dwan6767/UNIOPME/README.md

# Power Meter V.0






An AC power meter project that measures RMS current, frequency, and THD using MicroPython on a Raspberry Pi Pico.

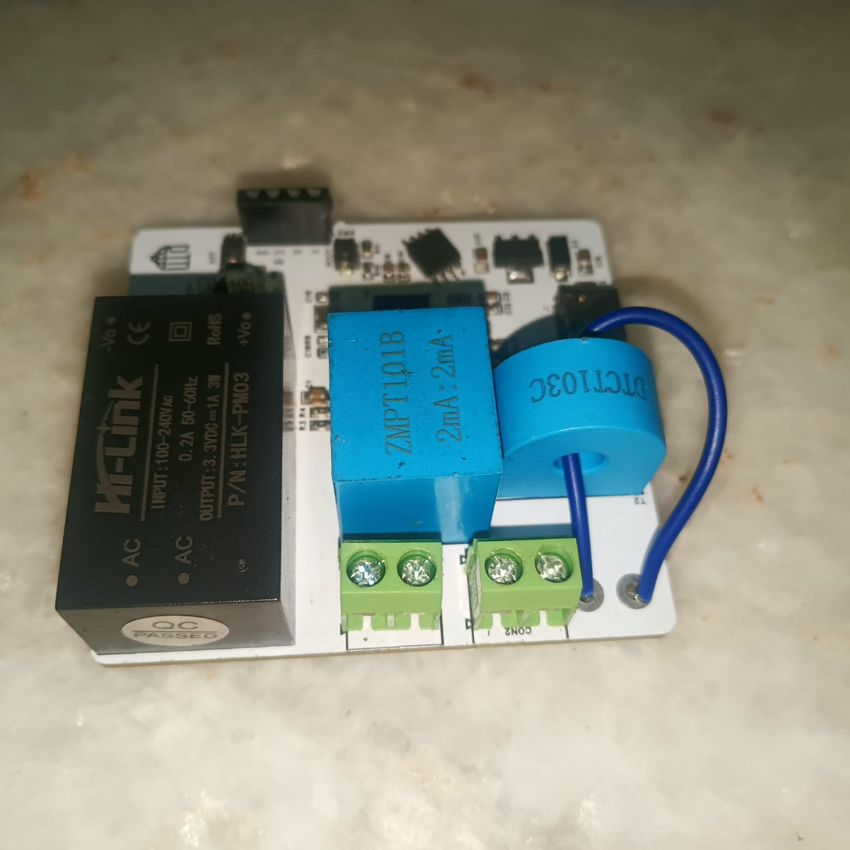
[picture p1: Models/0.png]
Power Meter


## Hardware

| Component | Description |
|---|---|
| Raspberry Pi Pico | Microcontroller |
| ZMPT101B | AC Voltage Sensor (GPIO 26) |
| ZMCT103C | AC Current Sensor (GPIO 27) |

**Schematic:** [View PDF](Designs/schematic.pdf)

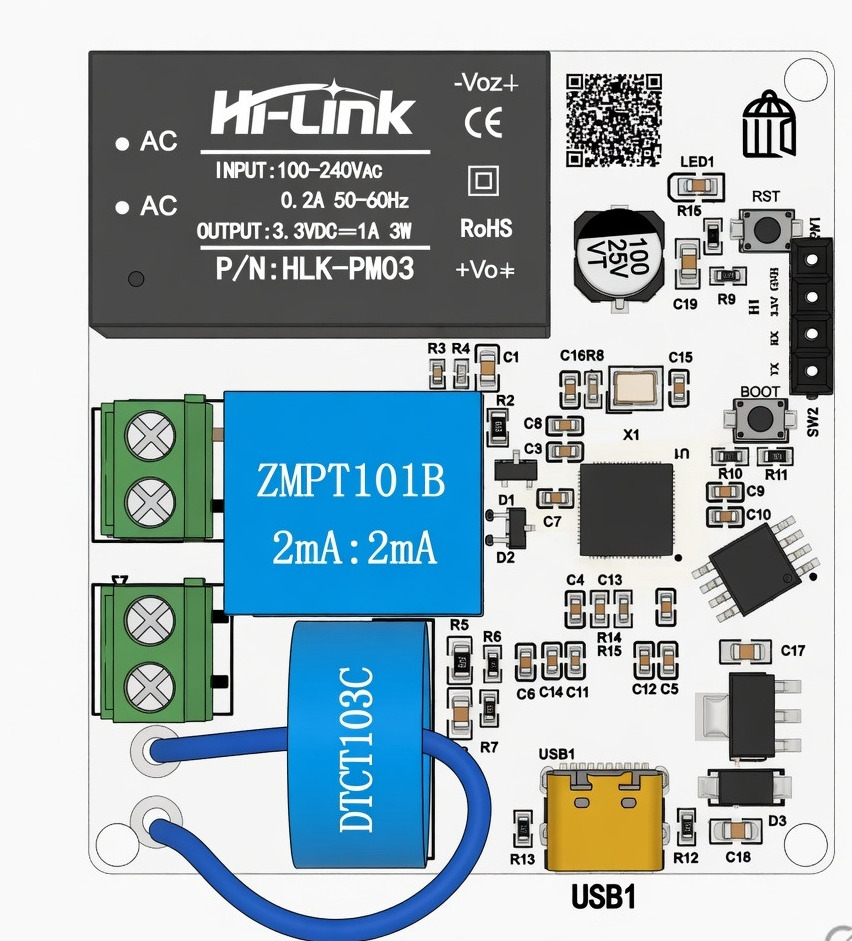
[picture p2: Models/2d_model.jpeg]
2D Model


## Firmware

Written in MicroPython. Samples at 5 kHz (500 samples per reading) and computes RMS values after DC offset removal.

### Features

- **RMS Current** measurement
- **Frequency** detection via zero-crossing
- **THD** (Total Harmonic Distortion) via FFT analysis
- Real-time serial output

### Calibration Factors

- `ICAL = 16.667 / 3` — Current calibration

### Usage

Flash `Firmware/main.py` to the Pico and monitor via serial REPL.

## Project Structure

```
Hardware/
├── Designs/        # Schematic (schematic.pdf), EasyEDA project (rp.eprj), Gerber files (power.zip)
├── Docs/           # Project report and documentation
├── Firmware/       # MicroPython source (main.py)
├── Models/         # 3D renders, photos, and enclosure PDFs
└── README.md       # This file
```

## Gallery

| 3D Renders | Test Setup |
|---|---|
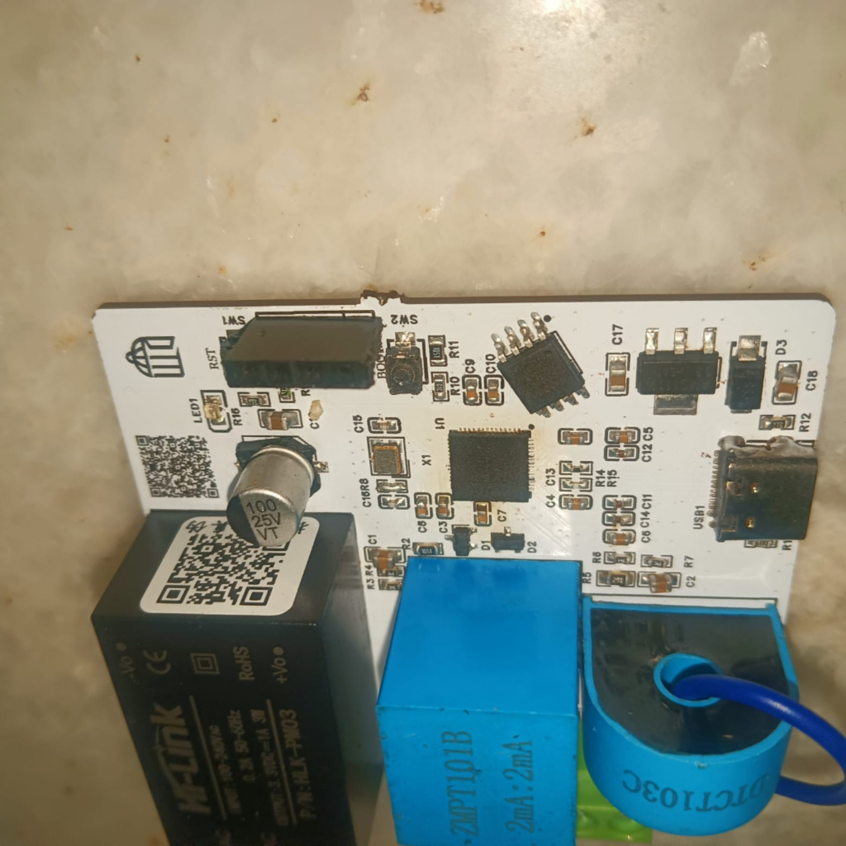
[picture p3: Models/1.png]
Model 1
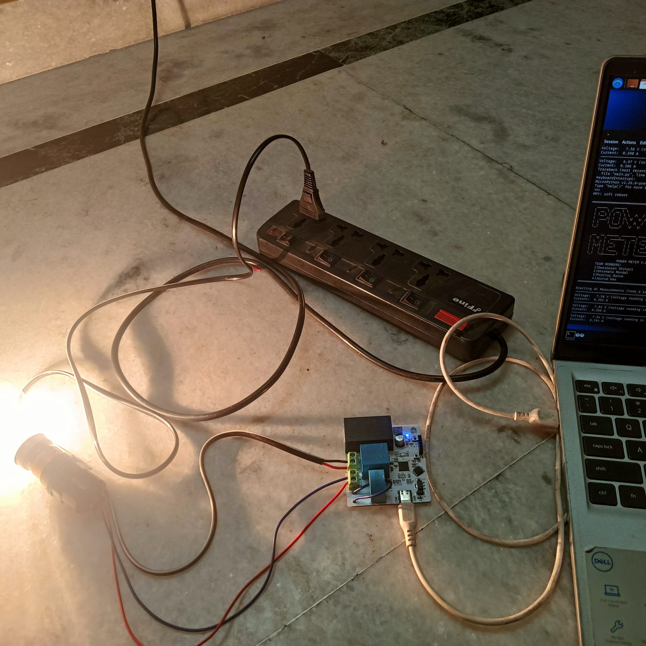
[picture p4: Models/test_setup.jpeg]
Test Setup
|  |  |
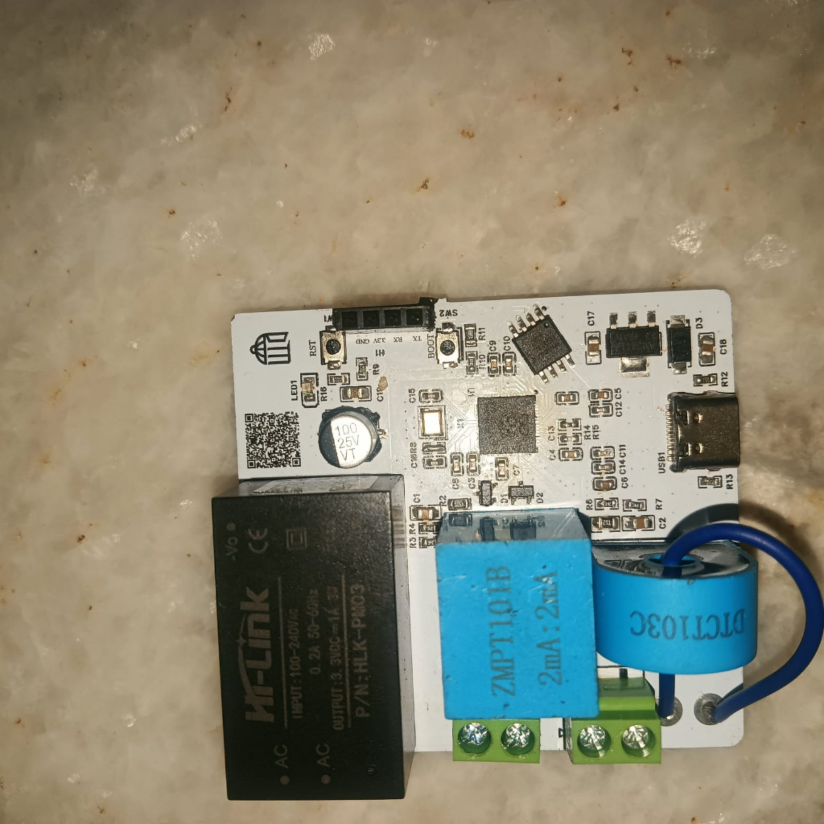
[picture p5: Models/2.png]
Model 2
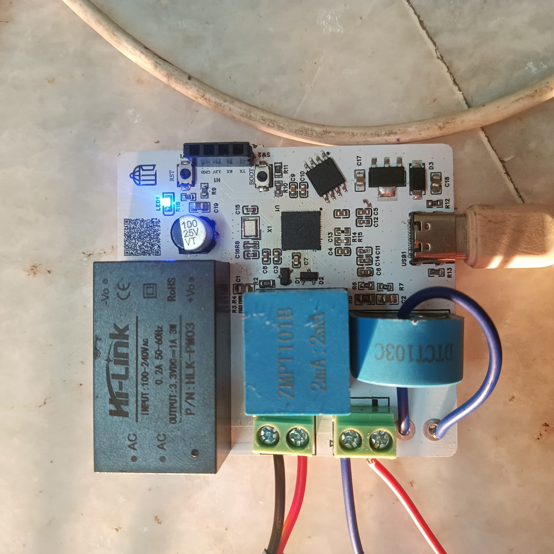
[picture p6: Models/test.jpeg]
Test
|  |  |
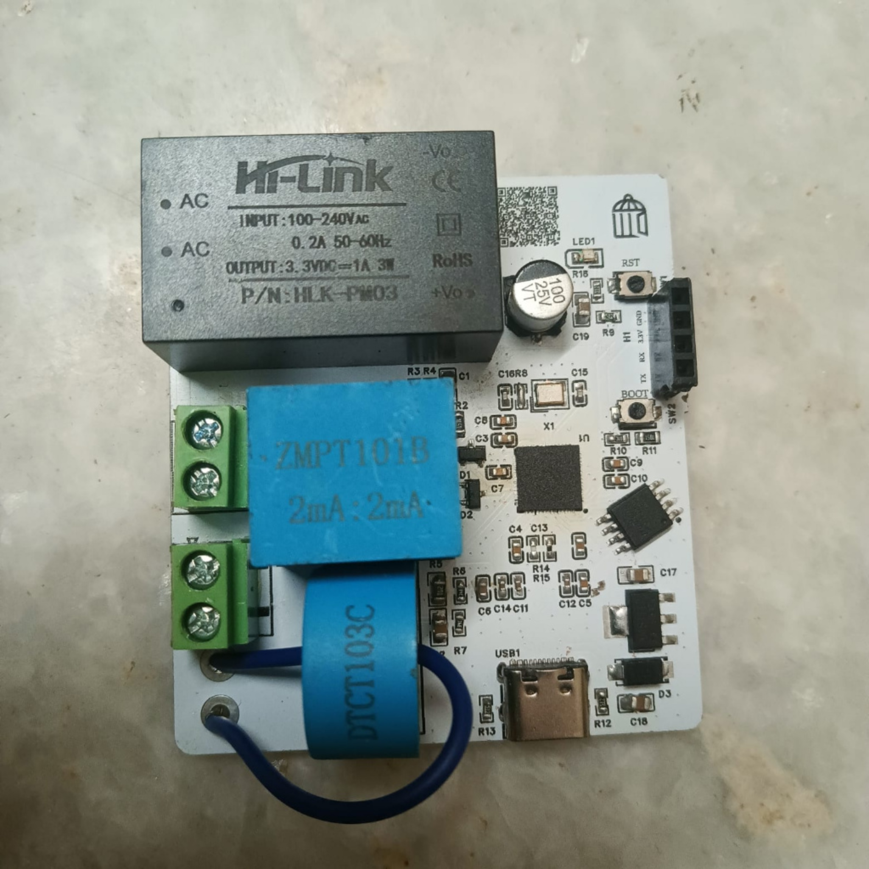
[picture p7: Models/3.png]
Model 3
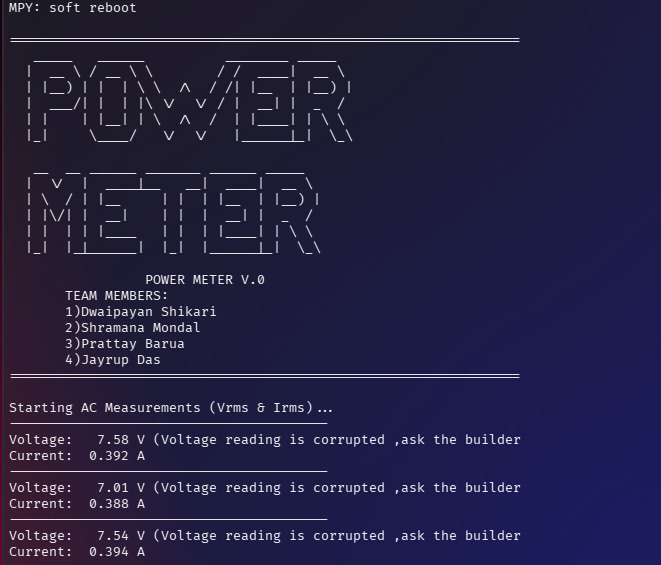
[picture p8: Models/test_soft.jpeg]
Test Software
|  |  |

## License

This project is certified [Open Source Hardware](https://oshwa.org/definition/) under the [CERN Open Hardware License v2.0](https://ohwr.org/cern-ohl).
