dwan6767/UNIOPME/Docs/AC_Power_Meter_Report.docx

AC POWER METER

Background Project | UG4 | Electrical Engineering

TEAM MEMBERS

Dwaipayan Shikari | Roll No: 002210801231

Shramana Mondal | Roll No: 002210801239

Prattay Barua | Roll No: 002210801246

Jayrup Das | Roll No: 002210801131

# 1. Project Overview

This document details the development of a custom AC Power Meter built as a Background Project for UG4 Electrical Engineering. The project evolved through iterative design — from a basic breadboard prototype to a fully custom PCB — demonstrating practical skills in embedded systems, analog circuit design, PCB layout, and firmware development.

Project Status: Functional but incomplete — current measurement is working correctly; voltage measurement requires a fix due to soldering issues on the RP2040.

## Development Timeline

Phase | Description
Version 1 (Prototype) | ESP32-based breadboard build with ZMPT voltage sensor and current transformer, HTTP web server for live data.
Testing | Calibration of voltage and current readings; identified noise issues with ESP32 ADC.
PCB Design | Redesigned around RP2040 for cleaner ADC; designed schematic and layout in EasyEDA Pro.
Manufacturing | PCB fabricated by JLCPCB (China), components hand-soldered locally.
Current Build | Functional unit with working current measurement; voltage pin under debugging.

# 2. Version 1 — Prototype

## Operating Principle

The first version was a straightforward implementation focused on core measurement functionality. The design used two primary sensing elements:

- ZMPT Voltage Sensor — Converts mains AC (230V) to a 0–5V signal centered at 2.5V (representing zero crossing). A 2/3 voltage divider was applied to step this down further to the 3.3V logic level of the ESP32.
- Current Transformer — The load-carrying wire is looped through the transformer core. The induced current is converted to a measurable voltage via a bleed resistor.

## Signal Conditioning — Voltage Divider

A simple resistor divider (R1 / R2) was used to scale the ZMPT output to safe ADC input levels:

Voltage Divider Ratio: 2/3
Input: 0–5V (from ZMPT)
Output: 0–3.3V (to ESP32 ADC pin)

## Data Access

An HTTP-based web server was implemented on the ESP32 using its onboard Wi-Fi module. This allowed any device on the local network to view live voltage and current readings through a web browser — a quick, simple, and robust solution for initial prototyping.

# 3. Testing Phase

Testing was conducted using a variable autotransformer to sweep the input voltage from 0V to 220V. Voltage and current readings were compared against a reference meter. Key findings:

- Voltage accuracy was acceptable across the range, with a consistent ~5% under-read.
- Current readings were weaker than expected due to choosing a current transformer with too high a turns ratio, which increased the signal-to-noise ratio unfavourably.
- These errors were addressed in the revised firmware through software calibration coefficients.

## Measurement Data

Actual (V) | Calculated (V) | Current (A) | Current Calculated (A)
220 | 211 | 0.32 | 0.46
210 | 204 | 0.31 | 0.44
200 | 192 | 0.3 | 0.4
190 | 182 | 0.29 | 0.4
180 | 173 | 0.28 | 0.39
170 | 163 | 0.27 | 0.37
160 | 154 | 0.26 | 0.35
150 | 143 | 0.25 | 0.32
140 | 133 | 0.24 | 0.3
130 | 124 | 0.23 | 0.29
120 | 115 | 0.22 | 0.222
110 | 105 | 0.21 | 0.21
100 | 96 | 0.19 | 0.185
90 | 85 | 0.18 | 0.178
80 | 77 | 0.17 | 0.157
70 | 67 | 0.16 | 0.13
60 | 57 | 0.14 | 0.125
50 | 47 | 0.13 | 0.12
40 | 37 | 0.11 | 0.08
30 | 28 | 0.09 | 0.06
20 | 18 | 0.07 | 0.047
10 | 9 | 0.05 | 0.02
0 | 0 | 0.01 | 0

# 4. PCB Design & Redesign

## Motivation

After the initial prototype was proven to work, the team chose to redesign the hardware into a proper PCB for a cleaner, more permanent build. The redesign also addressed a key limitation of the prototype:

Issue: The ESP32's ADC is noisy and non-linear, making accurate RMS calculations difficult.

Solution: Replaced with RP2040 (Raspberry Pi), which features a cleaner 12-bit ADC. When used with MicroPython, the scale is mapped to 0–65535 (16-bit equivalent).

## Schematic — Circuit Blocks

- Voltage Measurement: DC 1.65V bias + AC swing + input pin protection diodes
- Current Measurement: DC 1.65V bias + AC swing
- Power Supply: Dual-input — USB and HLK-PM03 AC-DC converter (100–240V input, 3.3V/1A output)
- MCU: Raspberry Pi RP2040 with 2MB external flash (W25Q32BSSIG)

## PCB Fabrication

EDA Tool: EasyEDA Pro

Manufacturer: JLCPCB, China (PCB only)

Assembly: Hand soldered manually — leaded solder and hot air

Connectors: KF128-5.08-2P-AA screw terminals for AC input

# 5. Firmware

## Sampling Strategy

The firmware was written in MicroPython for the RP2040. The sampling strategy is designed to capture clean RMS values of the AC waveform:

Sampling Rate: 5 kHz

Samples per Measurement Window: 500 samples

Window Duration: 20 ms (one full 50 Hz cycle)

Samples per Half Cycle: ~10 samples (sufficient for basic RMS)

Note: Increasing the sampling frequency and sample count would allow harmonic analysis and power quality measurement in future revisions.

## RMS Calculation Algorithm

The DC offset removal and RMS calculation pipeline:

1. Collect raw ADC samples

2. Sum all samples → calculate DC offset (average)

3. Subtract DC offset from each sample → true AC waveform

4. Square each sample

5. Average the squared values → mean square

6. Take square root → RMS value

## Configuration (power_meter.py)

## Configuration

SAMPLES = 500

SAMPLE_DELAY_US = 200

ADC_VREF = 3.3

ADC_COUNTS = 65535

## Calibration

VCAL = 268.97

ICAL = 16.667 / 3

## Hardware Init

adc_v = ADC(Pin(26)) # Voltage input

adc_i = ADC(Pin(27)) # Current input

# 6. Known Issues & Limitations

## Hardware Issues

- The RP2040 QFN package was hand-soldered without solder paste or stencil. A few pads are likely bridged or lifted, causing incorrect readings on the voltage ADC input (Pin 26). Current measurement (Pin 27) is reading correctly.
- No test pads were included in the PCB design, making it difficult to probe signals for debugging without risking further damage.
- Web logging (originally planned via an ESP8266 module) was dropped due to PCB space and complexity constraints.

## Logistics

- PCB was ordered via an Indian broker to avoid customs delays experienced with direct international shipping. This reduced cost but significantly increased lead time.
- Indian PCB manufacturers were considered but found to be lower quality compared to JLCPCB for this type of fine-pitch board.

## Planned Fixes for Next Revision

- Add test pads for all critical signal nodes (ADC inputs, bias voltage, power rails).
- Use solder paste and a stencil for RP2040 assembly, or specify PCBA service.
- Re-integrate web logging module on the PCB.
- Increase sampling rate for harmonic analysis capability.

# 7. Cost & Timeline

Item | Details
Design Phase | ~1 week
PCB Procurement & Shipping | 2–3 weeks
Soldering & Testing | 2–3 days
Total Build Time | ~1 month
Total Component Cost | ₹2,500–₹3,000 (excl. labour, electricity, soldering)

# 8. Team Contributions

Team Member | Roll No. | Contributions
Dwaipayan Shikari | 002210801231 | PCB Design, Logistics & Soldering
Shramana Mondal | 002210801239 | Firmware Development
Prattay Barua | 002210801246 | Logistics, Component Sourcing & Testing
Jayrup Das | 002210801131 | Soldering, Testing & 3D Models

# 9. Repository & References

GitHub Repository: github.com/dwan6767/uniopme

All technical details including full schematics, firmware source code, PCB Gerber files, and 3D models are available in the project repository.

Thank You
