dwan6767/UNIOPME/Docs/POWER METER-2.pdf

# AC Power Meter

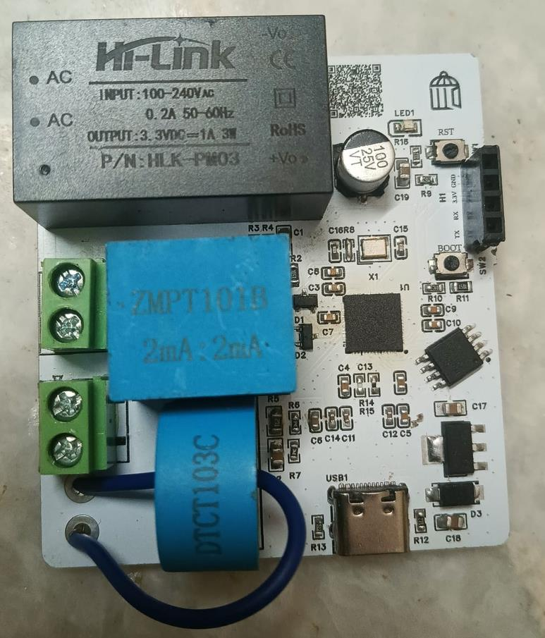
[picture p16: figure]

back ground project , ug4 , electrical engineering Team Members

dwaipayan shikari , roll no - 002210801231 shramana mondal , roll no - 002210801239 prattay barua, roll no - 002210801246 jayrup das , roll no - 002210801131

WHAT DONE TILL NOW..

FIRST VERSION --> TESTING --> GOT BORED --> PCB DESIGN --> THIS BUILD --> STILL INCOMPLETE BUT WORKS

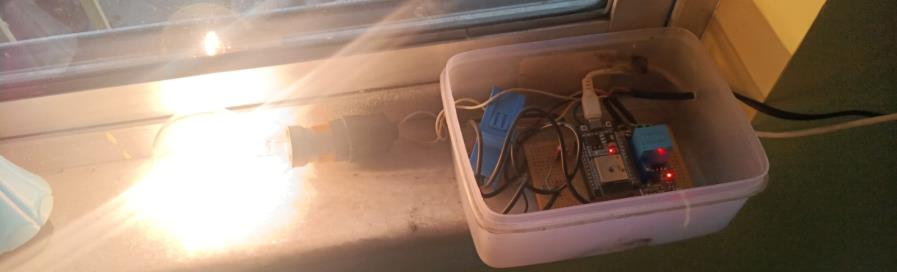
[picture p17: figure]
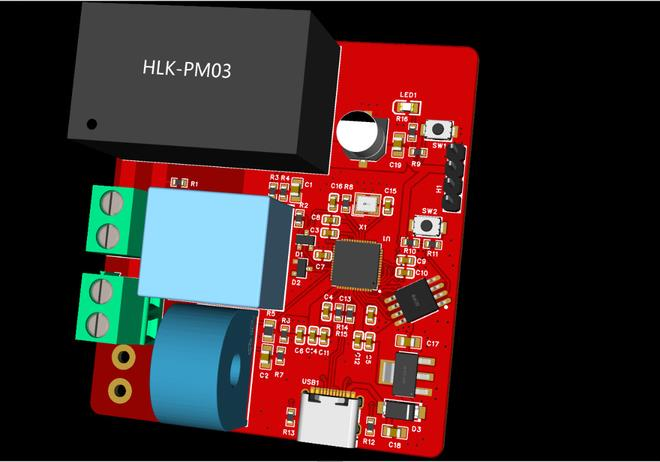
[picture p18: figure]
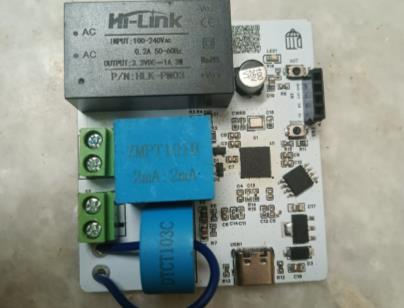
[picture p19: figure]

The first version
it was basic, main operating principle was to measure from zmpt voltage sensor and current transformer
scheme was
zmpt module converts ac 230v to 0-5vlevel , 2.5v was zero , but in our case we used a simple voltage divider, ⅔ ratio , to feed it into esp32 3.3v

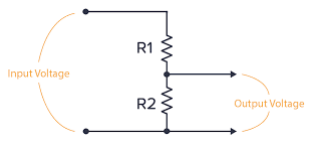
[picture p20: figure]

then , simple current transformer , the load wire loop is passed , and current induced , then a bleed resistor to converts it into voltage

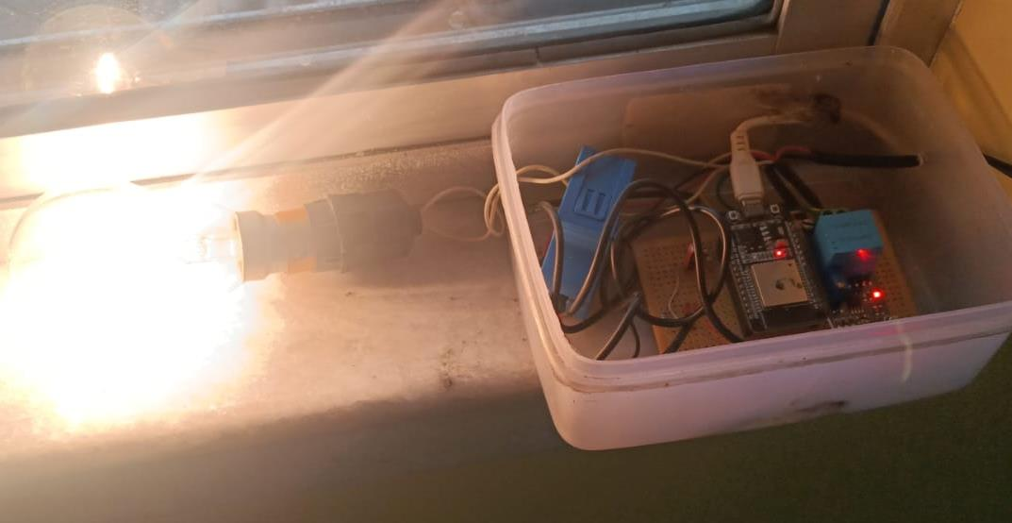
[picture p21: figure]

quick , simple , robust , then for access we used esp32’s wifi port , we made a http based web server , to see live voltage and current data

### testing phase

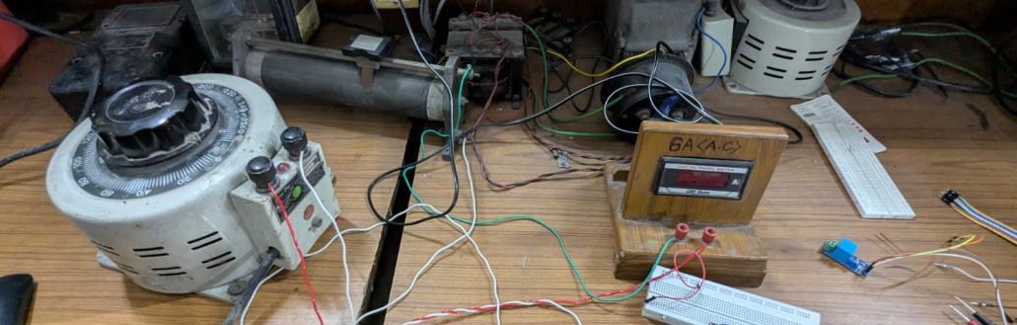
[picture p22: figure]
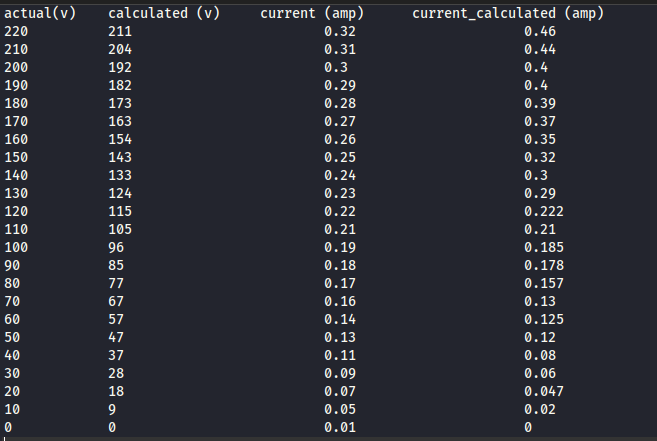
[picture p23: figure]

got some error , voltage was almost ok , current reading was weak though , naively choose highest turns ratio current transformer ,so , signal to noise ratio was high

any way the revised firmware has these things calibrated

## GOT BORED

with things done within few weeks , team members grew bored

but boredom brings purpose

so started to design a pcb to fit all components

but the adc of esp32 is noisy so , choose a simpler high performance mcu , rp2040 , 12 bit (but using micropython so scale is shifted to 0-65535)

Here is the schematic...

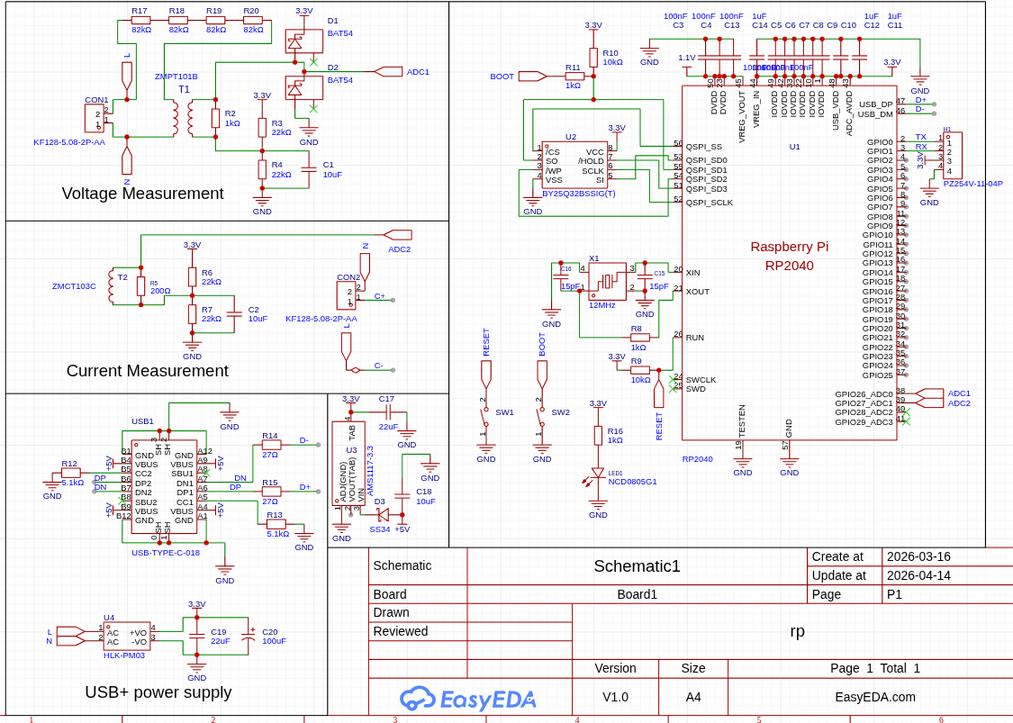
[picture p24: figure]

voltage measurement(dc 1.65 v bias+ac swing+pin protection )

current measurement(dc 1.65v bias+ac swing)

usb+ ac to dc power supply

### pcb design

done on easyeda pro software

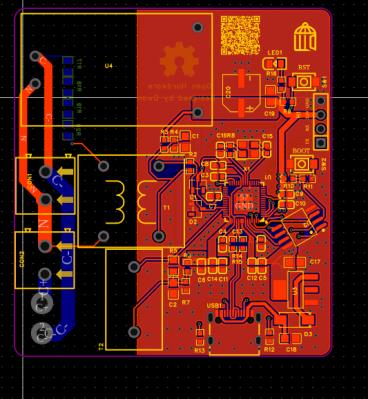
[picture p25: figure]
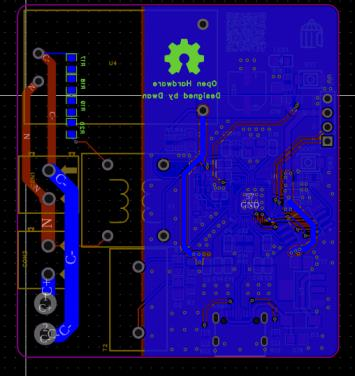
[picture p26: figure]
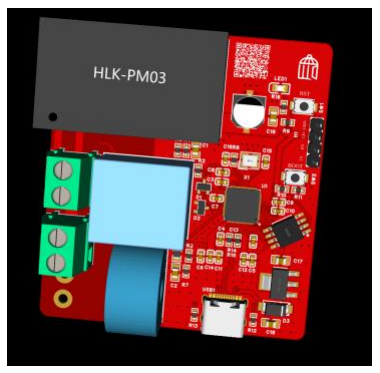
[picture p27: figure]
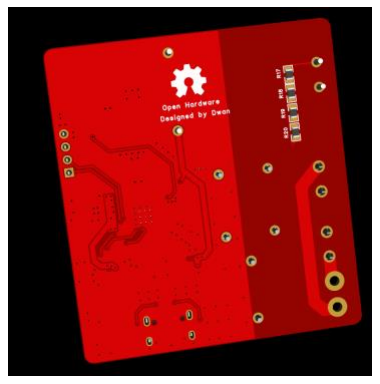
[picture p28: figure]

manufactured using jlcpcb china(pcb only), then hand soldered manually

## this build

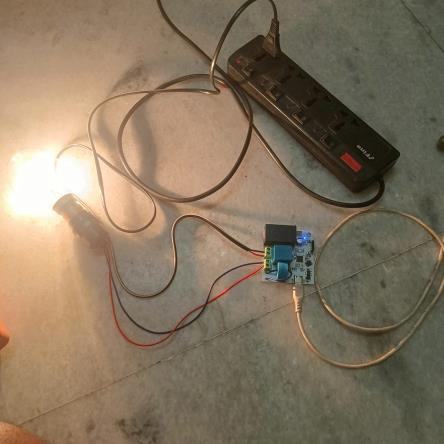
[picture p29: figure]
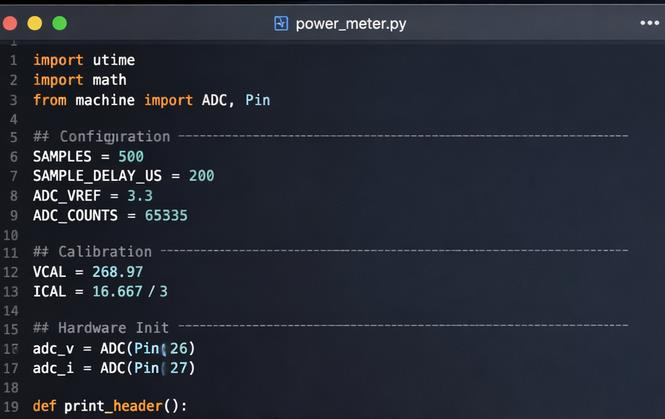
[picture p30: figure]
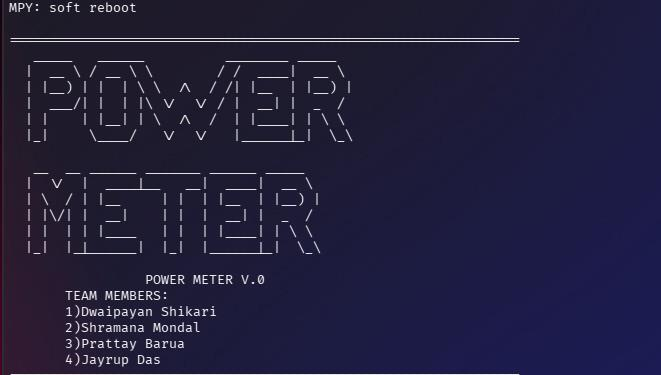
[picture p31: figure]

very simple process yet again
choose a sampling rate of 5khz with 500 samples per second, each 20ms window or half get 10 samples , more than enough to get proper , although if we aim for harmonics and other stuff , just have increase sampling frequency and samples
raw readings -->added --> get offset --> subtract from original --> get true ac reading --> squared --> rms

## issues still to fix and behind the scenes

the soldering of rp2040 is causing few issues, since it is manually soldered without any solder paste or stencil , just using leaded solder and hot air , few connections are supposedly of the place , so on the voltage pin the
reading is wrong , but current pin is perfect
also initially planned to put a web logger too, but of design naively did not put any testpads and soldering could still be an issue

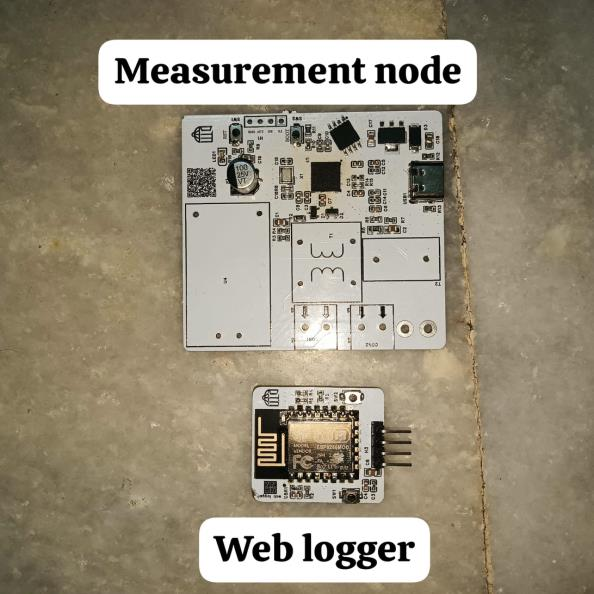
[picture p32: figure]

initial plan
also logistics was troublesome too , since from previous experiences had to deal with customs , so this time choose an indian broker , costs less but long time , also
few indian manufactures are there but not as good quality as jlcpcb

# MODELS AND FIRMWARES

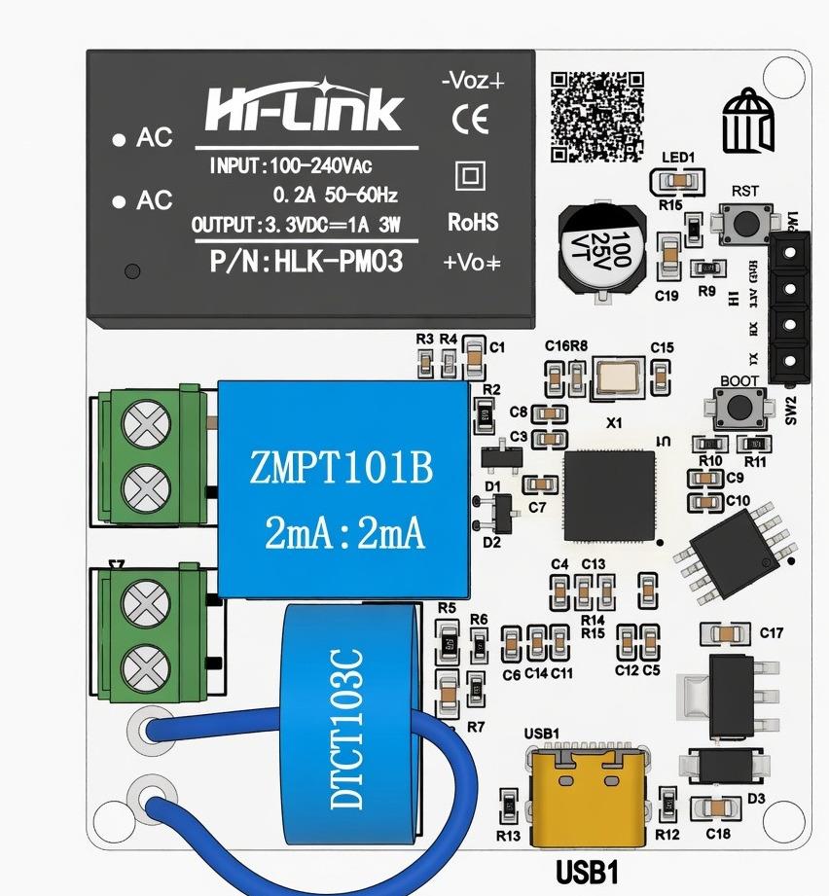
[picture p33: figure]

ALL THE TECHNICAL DETAILS ARE IN GITHUB.COM/DWAN6767/UNIOPME

## COSTS AND TIME TAKEN TO BUILD

1 WEEK OF DESIGN + 2-3 WEEKS OF GETTING + 2-3 DAYS =1 MONTH
SOLDERING AND TESTING
TOTAL COST OF PROJECT (EXCLUDING SOLDERING , ELECTRICITY AND FREE LABOUR) = 2500 -3000

# Contributions (BOTH VERSIONS)

dwaipayan shikari (PCB DESIGN + PART OF LOGISTICS AND SOLDERING ) shramana mondal ( FIRMWARE)
prattay barua (LOGISTICS , COMPONENT SOURCING ,TESTING)
jayrup das (SOLDERING ,TESTING , 3D MODELS)
