dwan6767/UNIOPME/Designs/schematic.pdf

# QSPI_SD3 51 DVDD ⁵⁰

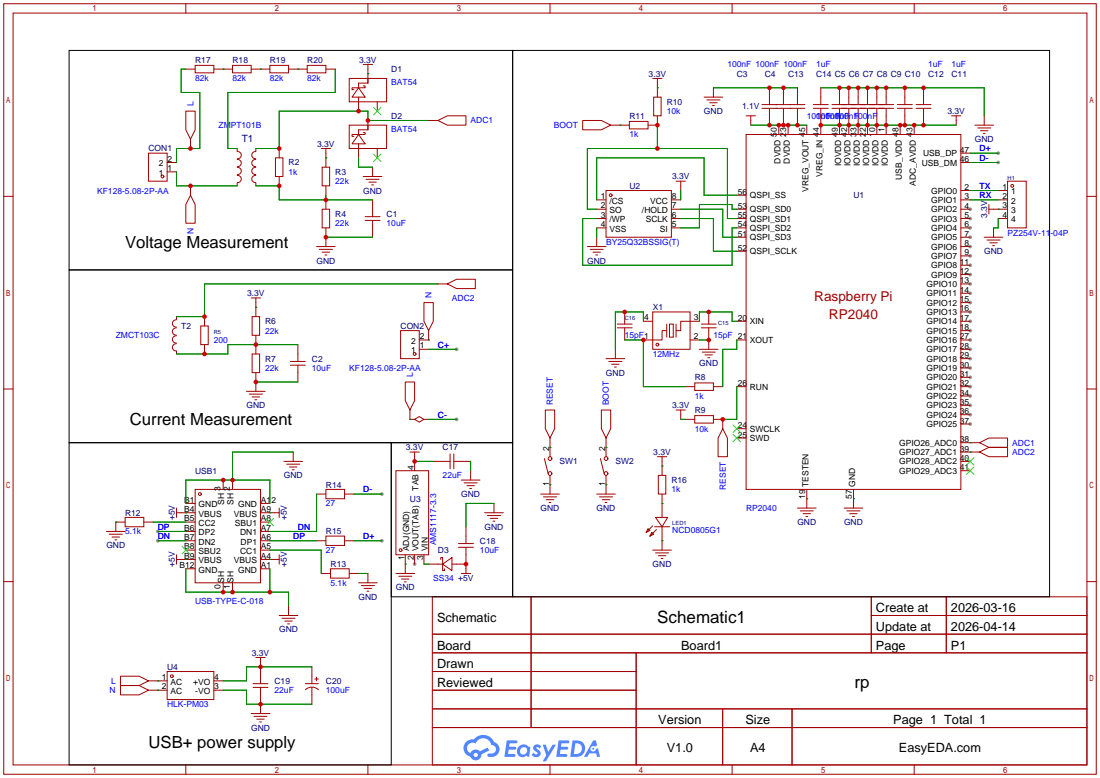
[picture p34: page 1]

Schematic | Schematic1 | Create at | 2026-03-16

Update at | 2026-04-14

Board | Board1 | Page | P1
Drawn | | rp
Reviewed

Version | Size | Page 1 Total 1
V1.0 | A4 | EasyEDA.com
