dwan6767/UNIOPME/(list of files, drawings)

Other design files:
Designs/rp.eprj
