dwan6767/UNIOPME/(commit log)

2026-04-29 Have Gerber , raw Easyeda Pro files
    [rp.eprj]
2026-05-01 Update firmware: remove voltage, add frequency and THD measurement
2026-06-01 Add AC Power Meter V0 report and HTML summary
