dwan6767/UNIOPME/(notices)

Notices in the files:
README.md:
License: CERN-OHL-P
